robomakery/pvc-powerchair/README.md

# PVC Powerchair

Pediatric powerchair initially developed at BYU and the [Open Wheelchair Foundation](http://openwheelchair.org/).

This project tracks enhancements to the chair made by [Robomakery](http://robomakery.com).

## Project Summary

[Short Google Slides Presentation](https://docs.google.com/presentation/d/e/2PACX-1vQH72_SPbROlJtIxm5qiG1kyvUSaIGlaVXuoVhn0pRb-agA25kUbpgHu_BZxM33IaVWwLDGMfL6djqC/pub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)

## Getting Involved

We welcome new contributors!

First, there is a Google Group mailing list for development discussion:

https://groups.google.com/forum/?hl=en#!forum/robomakery-pvc-chair

Please join that group and introduce yourself.  We also have bi-weekly online planning meetings via Zoom.

If you are in the San Diego area, we also meet to discuss this project on the first Tuesday of every month as part of the [San Diego Robotics Club](https://www.meetup.com/roboticsclub/).

## Tools

* [FreeCAD](https://www.freecadweb.org/)
* [ROS](http://www.ros.org/)

## Versions

### Version Currently Under Development:

*0.1.0*

## License Information

[Software is licensed under GNU General Public License V3](SOFTWARE_LICENSE)

[Hardware is licensed under CERN Open Hardware Licence v1.2](HARDWARE_LICENSE)
