robomakery/pvc-powerchair/hardware/cad/README.md

We use [FreeCAD](https://www.freecadweb.org/) for CAD and store the files here.
