robomakery/pvc-powerchair/software/src/pvcchair_description/README.md

pvcchair_description
===

To generate the URDF description, run

```bash
rosrun xacro xacro $(rospack find pvcchair_description)/urdf/pvcchair.urdf.xacro
```
