robomakery/pvc-powerchair/archive/README.md

### Version 5

Theme: Rocker-Bogie Experiment

Updates:

* Rocker-Bogie Suspension
* Self-leveling seat

Prototype Completion Date: TBD

[read more](v5)

### Version 4

Theme: Metal Frame, oDrive, Initial ROS

Updates:

* oDrive Motor Controller
* oDrive Brushless Motors + encoders + gearbox
* oDroid ROS Control
* Metal Frame w/ MakerPipe
* Front-wheel drive

Prototype Completion Date: Build In Progress

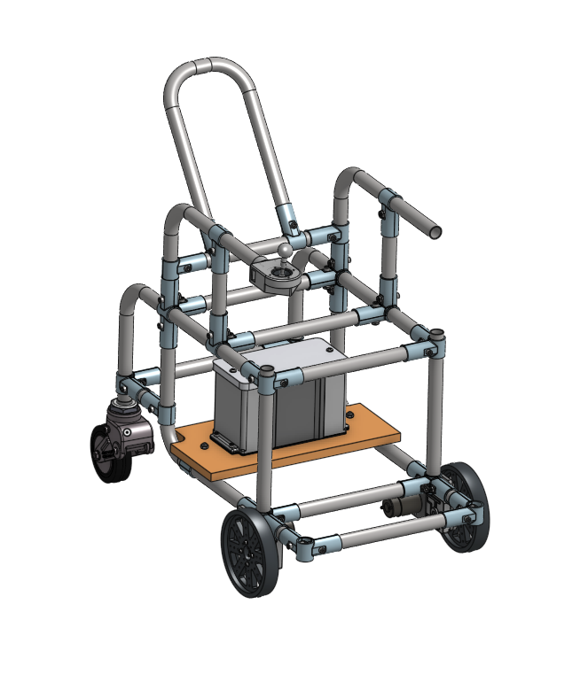
[picture p1: archive/v4/images/pvc-chair-v4-design.png]
PVC Powerchair v4 frame


[read more](v4)

### Version 3

Theme: UCSD ECE 191 Winter / Spring Projects

Updates:

* Brushless Hub Motors with Hall Sensors
* LiFePo4 Battery
* Rear-wheel drive

Prototype Completion Date: 2018-06-15

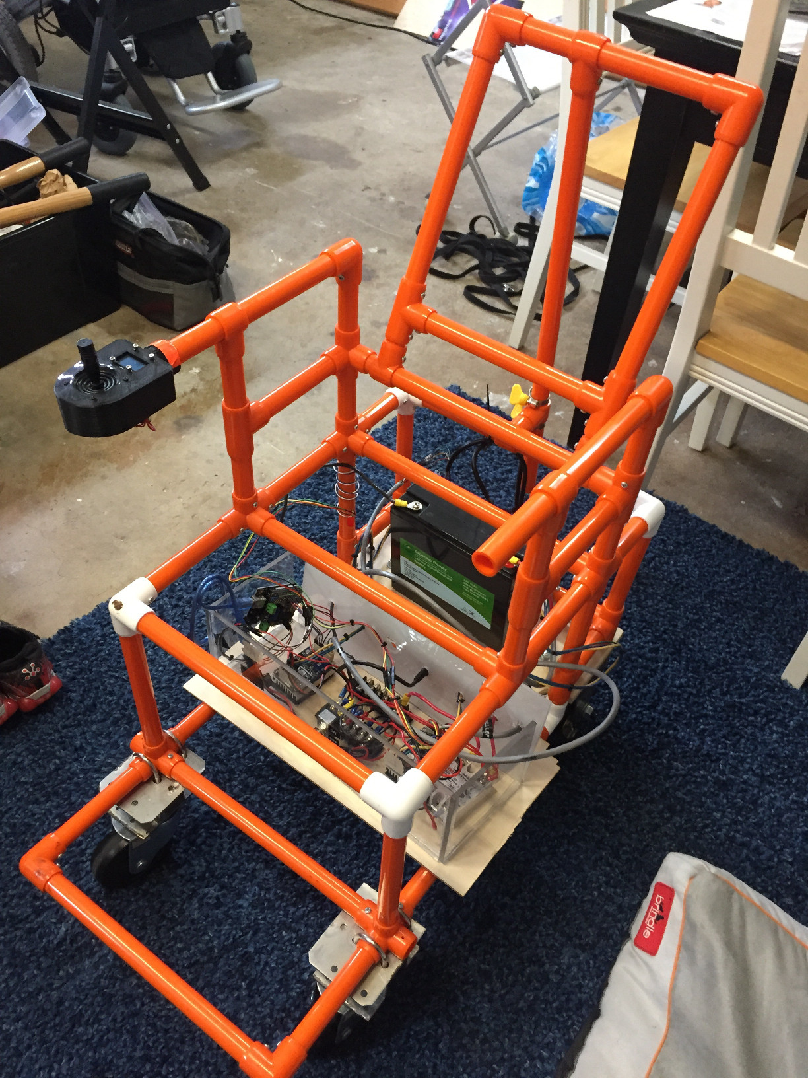
[picture p2: archive/v3/images/pvc-chair-v3-1.jpg]
PVC Powerchair v3 1


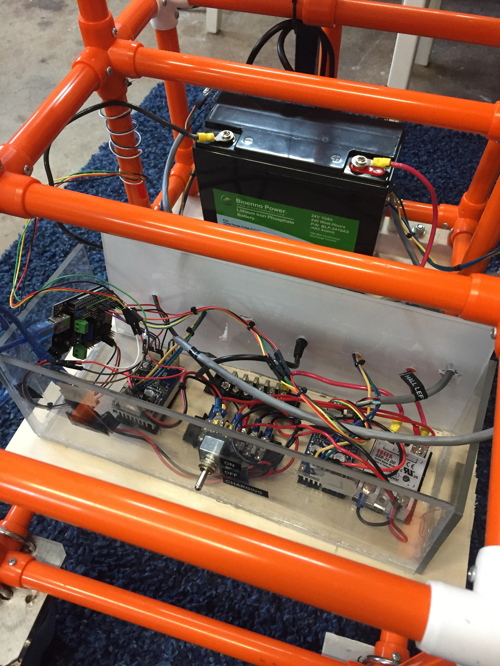
[picture p3: archive/v3/images/pvc-chair-v3-2.jpg]
PVC Powerchair v3 2


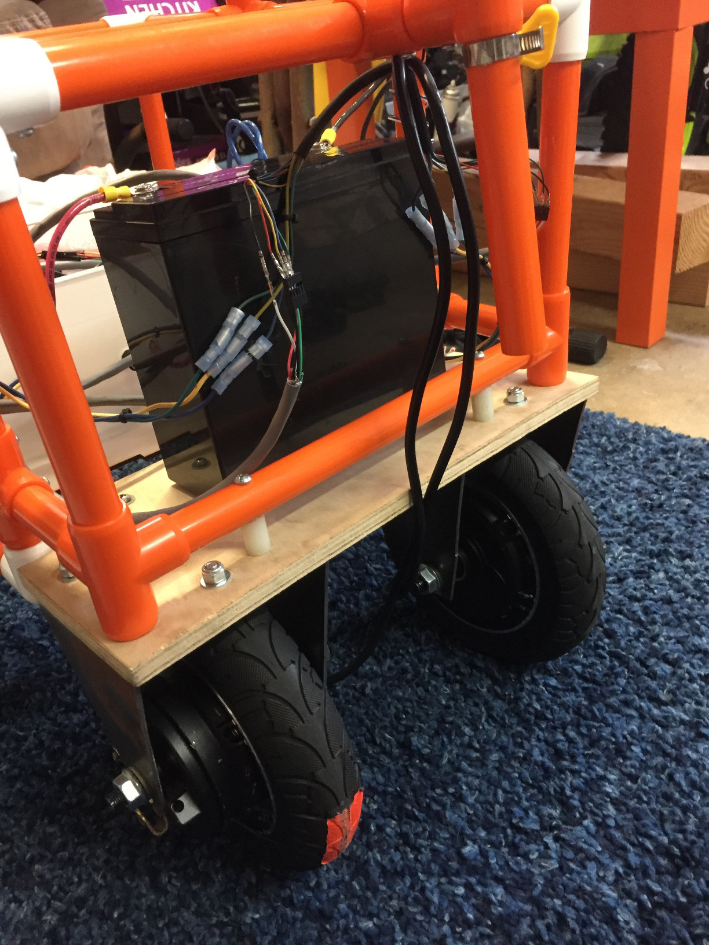
[picture p4: archive/v3/images/pvc-chair-v3-3.jpg]
PVC Powerchair v3 3


[read more](v3)

### Version 2

Theme: Move to COTS electronics

Updates:

* Arduino instead of custom boards
* Sabertooth Motor Controller
* OLED Battery Display
* Plug-in Battery Charging

Prototype Completion Date: 2017-11-04

PVC Powerchair v2 test drive (https://www.youtube.com/watch?v=sLA0mYiXbEk)

[read more](v2)

### Version 1

Theme: Original design build

Updates:

* Minor changes to original design

Prototype Completion Date: 2016-04-27

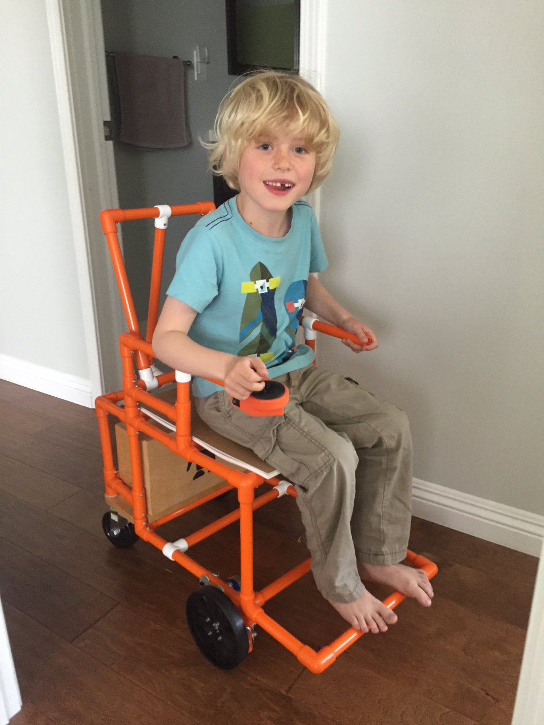
[picture p5: archive/v1/images/pvc-chair-v1.jpg]
PVC Powerchair v1 with tester


[read more](v1)
