robomakery/pvc-powerchair/archive/v4/README.md

## PVC Chair Version 4

Status: design in progress

Theme: Metal Frame, oDrive, Initial ROS integration

Updates:

* oDrive Motor Controller
* oDrive Brushless Motors + encoders + gearbox
* oDroid ROS Control
* Metal Frame w/ MakerPipe
* Front-wheel drive

### Docs

[BOM](design/PVC_CHAIR_V4_BOM_20181205_005.xls)

[OnShape CAD Model](https://cad.onshape.com/documents/9732789dff1ad6d245e6f6cd/w/41a982015f5ddfd27778e331/e/463536132cf1bdc68d806583)

### Contributors

* Dylan Vaughn
* Aki Kono
* Steven Berneberg
* Hamid Badiozamani
* Collins Mwangi

### Gallery

PVC Version 4

PVC Powerchair v4 frame
