robomakery/pvc-powerchair/archive/v3/README.md

## PVC Chair Version 3

Status: prototype completed on 2018-06-15

Theme: UCSD ECE 191 Winter / Spring Projects

Updates:

* Brushless Hub Motors with Hall Sensors
* LiFePo4 Battery
* Rear-wheel drive

### Contributors

Project Mentors

* Dylan Vaughn
* Jack Silberman

UCSD ECE 191 Project Members

_Winter 2018_

* Alex Tam
* David Lee
* Emily Reveles

_Spring 2018_

* Darlene Montesano
* David Lai
* Ibrahim Aldabbagh
* Jooyoung Park

### Gallery

PVC Version 3

PVC Powerchair v3 1

PVC Powerchair v3 2

PVC Powerchair v3 3
