robomakery/pvc-powerchair/archive/v2/README.md

## PVC Chair Version 2

Status: prototype completed on 2017-11-04

Theme: Move to COTS electronics

Updates:

* Arduino instead of custom boards
* Sabertooth Motor Controller
* OLED Battery Display
* Plug-in Battery Charging

### Docs

* [Component Diagram](docs/pvc-chair-component-diagram.png)
* [BOM](docs/PVC-Parts-List-V2.xls)

### Contributors

* Dylan Vaughn
* Steven Berneberg
* Aki Kono

### Gallery

PVC Powerchair v2 test drive

PVC Powerchair v2 test drive (https://www.youtube.com/watch?v=sLA0mYiXbEk)
