robomakery/pvc-powerchair/archive/v2/docs/electronics_diagram.pdf

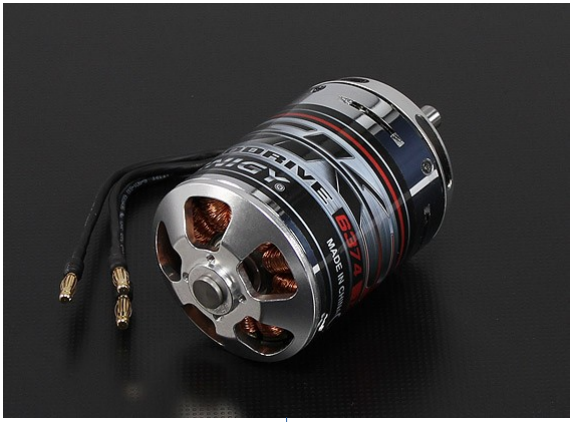
[picture p14: figure]

How are these
three wires connected?
- 3 phase motor drive signal

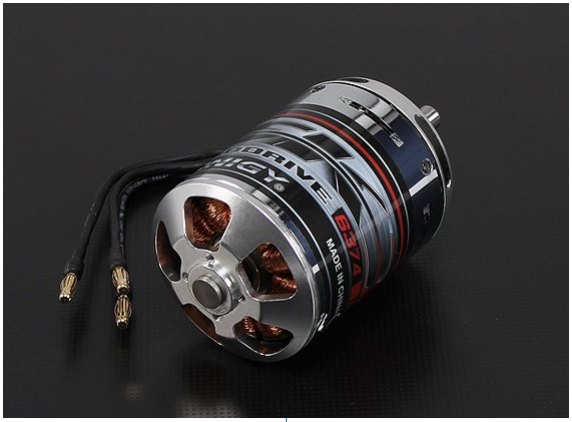
[picture p15: figure]

How are these
three wires connected?
- 3 phase motor drive signal

CAN add-on board
(On STM32f0-discovery)

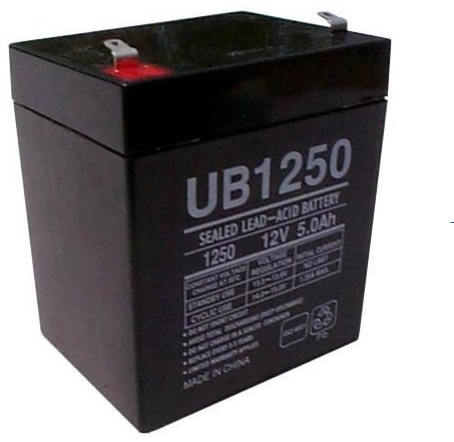
[picture p16: figure]
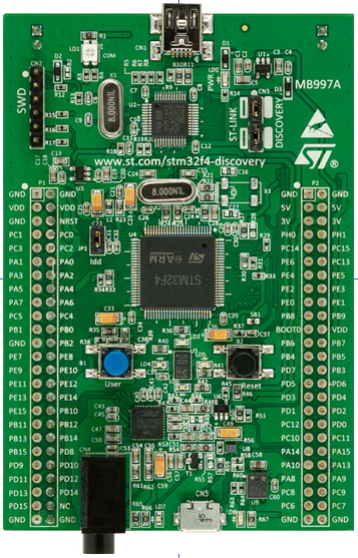
[picture p17: figure]
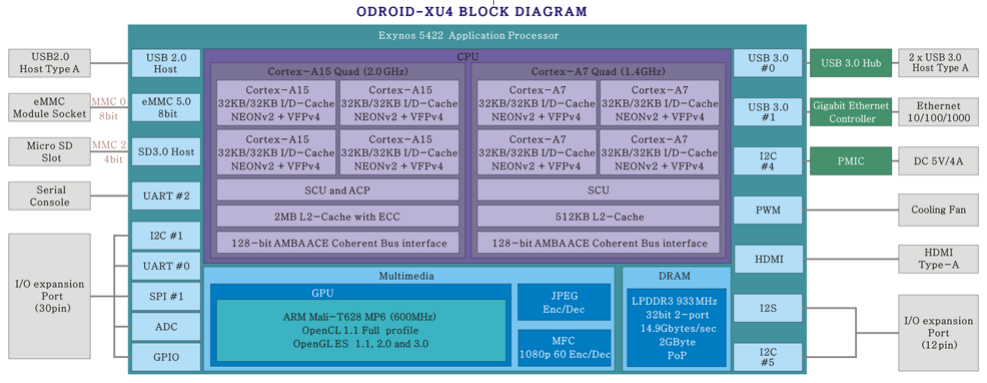
[picture p18: figure]
