robomakery/pvc-powerchair/BOM-20181206_002.xls

Sheet: MCs
Part Number | Description | Pipe Length (mm) | QTY | Total length
MC005 | See dwgs | 250 | 11 | 2750
MC006 |  | 117 | 4 | 468
MC007 |  | 62 | 6 | 372
MC009 |  | 200 | 1 | 200
MC0012 |  | 250 | 2 | 500
MC0013 |  | 250 | 1 | 250
MC010_S |  | 437 | 4 | 1748
MC011_S |  | 229 | 2 | 458
MC002_S |  | 317.5 | 2 | 635
MC0015_S |  | 151.5 | 2 | 303
TOTAL MC |  | mm | QTY | Overall length
 |  | 2264 | 35 | 7684
 |  | Convert to Inches |  | 302.5
 |  | Convert to feet |  | 25.2

Sheet: Cost Rollup
Part | Price | QTY | Part # | Retailer | Web Page | Date Ordered | Date Received | Sub-Total
Metal Conduit & Maker Pipe Connectors, end plugs + Hardware
3/4 inch MC pieces | $5.90 per foot | 25.2 feet= (2.52 times) |  | Home Depot |  |  |  | $14.87
4-Way MP Connector | $6.75 | 4 |  | Maker Pipe | https://www.makerpipe.com/shop |  |  | $27.00
90 degree MP Connector | $5.25 | 12 |  | Maker Pipe | https://www.makerpipe.com/shop |  |  | $63.00
T MP Connector | $2.75 | 16 |  | Maker Pipe | https://www.makerpipe.com/shop |  |  | $44.00
45 degree MP connector | $4.25 | 4 |  | Maker Pipe | https://www.makerpipe.com/shop |  |  | $17.00
End Plug/Rubber plugs | $0.50 | 13 |  | Maker Pipe | https://www.makerpipe.com/shop |  |  | $6.50
M6 Lock nuts | $0.15 | 62 |  | Grainger | https://www.grainger.com/category/hex-nuts/nuts/fasteners/ecatalog/N-8li |  |  | $9.30
M8 Lock nuts | $0.15 | 4 |  | Grainger | https://www.grainger.com/category/socket-head-cap-screws/socket-screws-and-set-screws/fasteners/ecatalog/N-15gx |  |  | $0.60
M6x1x35 Socket Head Cap Screw | $0.16 | 52 |  | Grainger | https://www.grainger.com/category/socket-head-cap-screws/socket-screws-and-set-screws/fasteners/ecatalog/N-15gx |  |  | $8.55
M6x1x16 Socket Head Cap Screw | $0.12 | 4 |  | Grainger | https://www.grainger.com/category/socket-head-cap-screws/socket-screws-and-set-screws/fasteners/ecatalog/N-15gx |  |  | $0.47
M6x1.25x12 Socket Head Cap Screw | $0.13 | 4 |  | Grainger | https://www.grainger.com/category/socket-head-cap-screws/socket-screws-and-set-screws/fasteners/ecatalog/N-15gx |  |  | $0.53
M6x1x45 Socket Head Cap Screw | $0.23 | 5 |  | Grainger | https://www.grainger.com/category/socket-head-cap-screws/socket-screws-and-set-screws/fasteners/ecatalog/N-15gx |  |  | $1.17
M6x1x40 Socket Head Cap Screw | $0.16 | 2 |  | Grainger | https://www.grainger.com/category/socket-head-cap-screws/socket-screws-and-set-screws/fasteners/ecatalog/N-15gx |  |  | $0.32
Shipping |  |  |  |  |  |  |  | $10.00
MP, MC, end plugs + hardware Total |  |  |  |  |  |  |  | $203.32
Frame
Seatbelt | $12.50 | 1 | 45928 | 1-800-WHEELCHAIR.COM | www.wheelchair.com |  |  | $12.50
Shipping |  |  |  |  |  |  |  | $4.00
Casters | $7.50 | 2 | PRES5024ZN-TPR | A1-Casters | www.a1casters.com |  |  | $15.00
Shipping
SeatCushion
Shipping
Shorter Bottom Acrylic Plate |  | 1
Bottom Acrylic Plate |  | 1
Upper Acrylic Plate |  | 1
Shipping
Frame Total |  |  |  |  |  |  |  | $31.50
DRIVETRAIN
BLDC Motor/Dual Shaft Motor | $70.00 | 2 | D5065 - 270KV | odrive | https://odriverobotics.com/shop/odrive-custom-motor-d5065 |  |  | $140.00
Quandrature encoder | $39.00 | 2 | CUI AMT102 | odrive | https://odriverobotics.com/shop/cui-amt-102 |  |  | $78.00
o Drive v 3.4 Motor controller | $119.00 | 1 | Drive v 3.4 | odrive | https://odriverobotics.com/shop/odrive-v35 |  |  | $119.00
Motor enclosure | $30.00 | 2 |  |  |  |  |  | $60.00
Caster socket | $5.00 | 2 |  |  | https://www.amazon.com/Oajen-caster-socket-diameter-4-pack/dp/B00B9KRA08?s=industrial |  |  | $10.00
Key Stock | $5.75 | 2 | WWG70025002501 | Stafford Manufacturing Corp. | https://www.grainger.com/product/GRAINGER-APPROVED-12-18-8-Stainless-Steel-Undersized-5UE61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 |  |  | $11.50
PX36 Gear box & accessories | $52.00 | 2 | 57PX-36 |  | https://www.aliexpress.com/item/High-Torque-Ratio-36-1-Reducer-China-Gear-Reducer-NEMA23-Stepper-Motor-Speed-Reducer-Planetary-Gearbox/32764813940.html |  |  | $104.00
Pnuematic Wheel | $38.00 | 2 | AM-0970 | AndyMark | https://www.andymark.com/products/8-in-pneumatic-wheel |  |  | $76.00
Motor&Gear Al Bracket | $25.00 | 2 |  |  | Customized piece |  |  | $50.00
Shaft Collar | $25.00 | 2 | 1A010AFCK | Stafford Manufacturing Corp. | https://datasheets.globalspec.com/ds/113/stafford/C499E490-FDFF-49F5-A299-68A67E42BAE7 |  |  | $50.00
M3-0.5x8 Socket Head Cap Screw | $0.15 | 4 |  |  | https://www.grainger.com/category/socket-head-cap-screws/socket-screws-and-set-screws/fasteners/ecatalog/N-15gx |  |  | $0.60
M3 washer | $0.15 | 4 |  |  | https://www.grainger.com/category/socket-head-cap-screws/socket-screws-and-set-screws/fasteners/ecatalog/N-15gx |  |  | $0.60
#40 Tap Drill |  | 1 |  |  |  |  |  | $0.00
M3-0.5 tap |  | 1 |  |  |  |  |  | $0.00
M5-0.8x8 Socket Head Cap Screw | $0.15 | 4 |  |  | https://www.grainger.com/category/socket-head-cap-screws/socket-screws-and-set-screws/fasteners/ecatalog/N-15gx |  |  | $0.60
M3 washer | $0.15 | 4 |  |  | https://www.grainger.com/category/socket-head-cap-screws/socket-screws-and-set-screws/fasteners/ecatalog/N-15gx |  |  | $0.60
 |  |  |  |  |  |  |  | $0.00
 |  |  |  |  |  |  |  | $0.00
 |  |  |  |  |  |  |  | $0.00
Shipping |  |  |  |  |  |  |  | $20.00
Drive Train Total |  |  |  |  |  |  |  | $720.90
ELECTRONICS
2 Axis Joystick | $19.99 | 1 | RB-Sct-283 | Robotshop | www.robotshop.com |  |  | $19.99
Arduino UNO |  |  |  |  |  |  |  | $0.00
H-Bridge |  |  |  |  |  |  |  | $0.00
Power converter |  |  |  |  |  |  |  | $0.00
Battery | $189.99 | 1 | BLF-2410AS |  | https://www.bioennopower.com/collections/24v-series-lifepo4-lithium-iron-phosphate-batteries/products/24v-10ah-lfp-battery-abs-blf-2410as |  |  | $189.99
Battery Charger | $39.01 | 1 | BPC-2402C |  | https://www.bioennopower.com/collections/24v-series-lifepo4-lithium-iron-phosphate-batteries/products/24v-10ah-lfp-battery-abs-blf-2410as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 |  |  | $39.01
Connectors | $20.00 | 2 |  |  |  |  |  | $40.00
Electronics box | $70.00 | 1 | YH-100806-03 | PolyCase | https://www.polycase.com/yh-100806 |  |  | $70.00
 |  |  |  |  |  |  |  | $0.00
 |  |  |  |  |  |  |  | $0.00
 |  |  |  |  |  |  |  | $0.00
Electronics Total |  |  |  |  |  |  |  | $358.99
Grand Total |  |  |  |  |  |  |  | $1314.71
