robomakery/pvc-powerchair/archive/v3/BOM.md

Motor Controllers:

* [Motor Controller - SODIAL(R)DC 12V-36V 500W Brushless Motor Controller Hall Motor Balanced Car Driver Board](https://www.amazon.com/gp/product/B01LQ4FF4O/ref=oh_aui_search_detailpage?ie=UTF8&psc=1)
