robomakery/pvc-powerchair/archive/v4/BOM.md

BOM
===

Frame
-----

*Electrical Metal Tubing*

* 3 * [10ft 3/4 inch EMT Tubing](https://www.homedepot.com/p/3-4-in-EMT-Conduit-101550/100400406) - $5.90/each

*Maker Pipe*

* 10 * [T connector](https://www.makerpipe.com/shop/maker-pipe-conduit-t-connector) - $2.75/each
* 2 * [4 Way connector](https://www.makerpipe.com/shop/four-way-connector-4mgmh) - $6.75/each
* 8 * [90 degree connector](https://www.makerpipe.com/shop/90-degree-connector-pre-sale) - $5.25/each

*Parts Subtotal*

```
(+
 (* 3 5.90)
 (* 10 2.75)
 (* 2 6.75)
 (* 8 5.25))
```

$100.70

*Tools Required*

* 1 * [pipe bender](https://www.homedepot.com/p/Ideal-3-4-in-EMT-Aluminum-Bender-Head-with-Handle-74-047/100341460) - $38.80/each

*Tools Subtotal*

```
(+
 (* 1 38.80))
```

$38.80

Battery
-------

* 1 * [LiFePo 24V 10Ah battery + charger](https://www.bioennopower.com/collections/24v-series-lifepo4-lithium-iron-phosphate-batteries/products/24v-10ah-lfp-battery-abs-blf-2410as) - $229.99/each

Drive Train
-----------

* 2 * [BLDC motor](https://odriverobotics.com/shop/odrive-custom-motor-d5065) - $69.00/each
* 2 * [Quadrature encoder](https://odriverobotics.com/shop/cui-amt-102) - $39.00/each
* 1 * [oDrive v3.4 Motor Controller](https://odriverobotics.com/shop/odrive-v35) - $119.00/each
* 2 * [Motor Enclosure](https://cad.onshape.com/documents/6668fd76e2dbada55127ed36/w/1e8250b1f83ac970e8ac258d/e/d9d08ef906d47e24e628fb72) - $30.00/each (ESTIMATE)
* 2 * [Planetary Gearbox](https://www.aliexpress.com/item/High-Torque-Ratio-36-1-Planetary-Gear-Reducer-For-NEMA23-Stepper-Motor-High-Precision-Low-Noise/32764813940.html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) - $51.30/each
* 2 * [Pneumatic wheels](http://www.andymark.com/8-inch-pneumatic-wheel-p/am-0970.htm) - $37.00/each
* 2 * [Caster wheels](http://www.footmaster.net/products/detail.asp?bic_code=Shock&small_code=GDS&p_name=GDS-100-ASS-LUD) - $30.00/each (estimate)
* 2 * [Caster Center Bolt] M12 X 1.75P (this should come as part of the caster assembly above)
* 2 * [Caster socket](https://www.amazon.com/Oajen-caster-socket-diameter-4-pack/dp/B00B9KRA08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) - $16/each  
* 2 * [Shaft Mounting Collars](http://shaft-collars-couplings.staffordmfg.com/item/all-categories/accu-flange--shaft-collars/1a010afck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) - $25.00/each (estimate)
* 2 * [Aluminum Bracket for Motor&Gear] measuring 145mm by 70 mm to be bent accordingly - $20 (estimate)
* 1 * [Acrylic Bottom plate] measuring 353mm by 345mm by 2mm - $?? 
* 1 * [Acrylic Bottom plate] measuring 335mm by 300mm by 2mm - $?? 
* 1 * [Anti-Vibration Foam](https://www.amazon.com/dp/B016C5FJE8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) - $10 
* 1 * [Electronics Box] 3D printed - $??
* 5 * [Rubber plugs] with 20.8mm diameter, for plugging into Conduit ends Check Home depot - $10 (estimate)
* 4 * [Rubber plugs 2] with 23.6mm diameter, for plugging into MC connectors Check Home depot - $10 (estimate)
* 8 * [M4 X 20] Hex Socket Head Cap Bolt - $1/each (estimate) 
* 8 * [M4 X 35] Hex Socket Head Cap Bolt - $1/each (estimate)
* 6 * [M5 X 55] Hex Socket Head Cap Bolt - $1/each (estimate) 
* 4 * [M6 X 12] Hex Socket Head Cap Bolt - $1/each (estimate) 
* 4 * [M6 X 20] Hex Socket Head Cap Bolt - $1/each (estimate)
* 40 * [M6 X 35] Hex Socket Head Cap Bolt - $1/each (estimate) 
* 2 * [M6 X 45] Hex Socket Head Cap Bolt - $1/each (estimate)
* 16 * [M4] Hex locknuts - $1/each (estimate)
* 6 * [M5] Hex locknuts - $1/each (estimate)
* 52 * [M6] Hex locknuts - $1/each (estimate)

```
(+
 (* 2 69)
 (* 2 39)
 (* 1 119)
 (* 2 30)
 (* 2 51.30)
 (* 2 37)
 (* 2 30)
 (* 2 16)
 (* 2 25)
 (* 2 20)
 (* 1 10)
 (* 1 10)
 (* 1 10)
 (* 74 1)
 (* 74 1))
```

$931.6

*Motor Cover to Motor Enclosure*

* 4 * M3-0.5x8 socket cap screw
* 4 * M3 washer

_Drill and tap into motor enclosure_

* #40 tap drill
* M3-0.5 tap

*Motor Cover to Planetary Gearbox body*

* 4 * M5-0.8x8 socket cap screw
* 4 * M3 washer

*Motor to Motor cover*

* 4 * M4-0.7x8 socket cap screw
* 4 * M4 washer

Seat
----

* 2 * yard outdoor fabric (fabric for this prototype purchased at [Threads](https://www.yelp.com/biz/threads-san-diego) for $17 / yard)
* 1 * sheet of thin plywood
* 20 * staples

*Tools*

* Staple gun
