robomakery/pvc-powerchair/archive/v2/hardware/printed_parts/JoystickEnclosure.STL

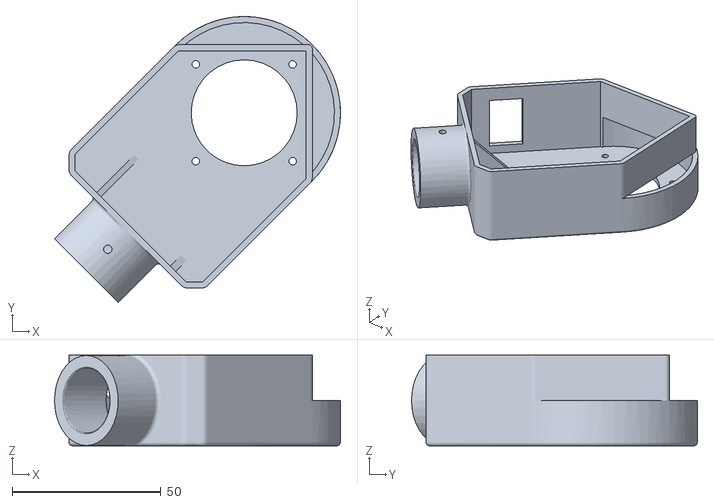
[picture p19: CAD file, 2017-03-30, an earlier design]
archive/v2/hardware/printed_parts/JoystickEnclosure.STL
96.0 x 96.0 x 30.5
