robomakery/pvc-powerchair/(list of files, cad)

Other CAD files:
hardware/cad/pvc-chair.FCStd
