robomakery/pvc-powerchair/CHANGELOG.md

Unreleased
----------

* Initial prototypes
* Moving documentation to wiki
