robomakery/pvc-powerchair/software/src/pvcchair_description/CHANGELOG.rst

^^^^^^^^^^^^^^^^^^^^^^^^^^^^^^^^^^
Changelog for pvcchair_description
^^^^^^^^^^^^^^^^^^^^^^^^^^^^^^^^^^

Forthcoming
-----------
* Redefined piping and connectors to allow use within a single link.
* Restructured main parts so that each defines a single link.
* Restructured xacro includes to be compatible with in order processing.
* Added urdf models for the gearbox plates, wheels and casters.
* Gathered urdf parameters in parameters.urdf.xacro.
* Added dae design files for the basic components.
* Added urdf models for the basic components.
* Added urdf model for the frame of the wheelchair.
