robomakery/pvc-powerchair/(threads)

Thread 1 (2016-05-06):

change to Arduino processor

dylanvaughn, 2016-05-06:
from @SBerneberg

The processor that will control the wheelchair has the following requirements:

2 – PWM – Speed control for right and left drive motor
2 – DIR – Direction control for right and left drive motor
2 – Analog In – The two potentiometers in the joystick
1 – UART – Rx/Tx for Bluetooth module
1 – I/O – LED Headlight control
2 – Analog In – Optional Battery Voltage and Battery current.

Looking at the Arduino offerings, only the Mega provides more that one UART.  Others have a UART but they are used for the USB interface and thus may not be used.

miliapa, 2016-06-15:
This might help with board selection:
http://makezine.com/comparison/boards/

There are several with built in bluetooth support.

Alternatively, look for a board with a bluetooth shield available.

If your goal is to use ROS, you might want to consider a board capable of running Linux.

bus710, 2016-06-25:
Since Arduino's basic approach doesn't accept timer interrupt, I rather pick other systems. I still need to consider affordable price tags though.

Thus, I am thinking to use STM32F0-disconvery or Mbed since both have pros such as decent price, enough performance, easy to use, and open echo system. Especially, the discovery board will be upgraded to OpenCR, which is a part of real time ROS system soon. (so the middleware in the board will natively exchange ROS message with a x86/Ubuntu based system.)

I want to listen from you about this idea.

dylanvaughn, 2016-06-28:
@bus710 can you give me more details on the Arduino interrupt issue?

Regarding high-level board design, I think we should have a micro linux computer (I have a [snickerdoodle](https://www.crowdsupply.com/krtkl/snickerdoodle) coming soon which we could use for this - or even something like the [Intel NUC](http://www.intel.com/content/www/us/en/nuc/overview.html)) which runs ROS and sends control instruction to arduino boards which interface with the motor drivers, etc. via the [ros_arduino_bridge](http://wiki.ros.org/ros_arduino_bridge).

Maybe we should make a diagram outlining the board setup - something like this:

https://lh3.googleusercontent.com/-_g2DF_fLgn4/V26gBZy1c4I/AAAAAAAAADA/8IWbXK99Ebge-WIxoAY7ONzaaNgUJDezACLcB/s1600/schema_JQR_5.jpg

bus710, 2016-06-28:
1.
as you know, polling may cause timing issues to run motors.

if we use too many motors over than arduino's maximum PWM output, we have
to drive one or more motors by using timer or polling. in this case,
polling can make some delay. (if we use arduino mega, that's nice to have.)
however, i agree that arduino can be the best approach for the first step.

2.
i wish we can use NUC to avoid compatibility issue in drivers (sensor,
network, and so on.) but we also need to think about power source.

3.
yes, let's talk about a rough diagram.

SJ
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

Closed 2017-05-03.

Thread 10 (2016-05-06):

Source remaining parts

dylanvaughn, 2016-05-06:

SBerneberg, 2016-05-17:
I have used these auto reset breakers with great success.  I usually mount them on the battery; a convenient location.  Here is a picture:
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

SBerneberg, 2016-05-17:
I usually get these in El Cajon for about $2.25 for a 30amp breaker.

dylanvaughn, 2017-05-03:
Find sources for these parts, purchase, and integrate into drawing and prototype v2:

* electro-mechanical circuit breaker instead of automotive fuse
* on / off switch
* charger port
* trickle charger adapter

dylanvaughn, 2017-07-07:
Still left to buy:

* Custom Arduino shield
* Voltage divider
* Fan
* JST connectors
* Power plug
* Power jack
* Hose Clamp

dylanvaughn, 2017-07-09:
@rbeetem for the custom arduino shield should I get this one:

http://www.jameco.com/z/A000082-Arduino-Arduino-Uno-Proto-Shield-PCB-only-_2152438.html

which is just the bare PCB only, or this one:

http://www.jameco.com/z/A000077-Arduino-Arduino-UNO-Proto-Shield-Rev-3-assembled_2152391.html

which has a couple of things already set up?

dylanvaughn, 2017-07-09:
@rbeetem is this what I want?  It is prime :)

https://www.amazon.com/Arduino-Proto-Shield-R3-Assembled/dp/B007QXTRNA

rbeetem, 2017-07-18:
The bare PCB is the one I would recommend.
http://www.jameco.com/z/A000082-Arduino-Arduino-Uno-Proto-Shield-PCB-only-_2152438.html

The only one is designed to have additional shields placed on top, which we currently have no desire to do.

dylanvaughn, 2017-07-22:
@rbeetem I'm planning on ordering this today - does it look right?

https://www.amazon.com/gp/product/B01J1KM3RM/ref=ox_sc_act_title_2?smid=A2OVMUS055KMW5&psc=1

rbeetem, 2017-07-23:
@dylanvaughn Looks reasonable to me.

Closed 2017-08-02.

Thread 11 (2016-05-06):

Buy/Build LiFePO4 battery pack

dylanvaughn, 2016-05-06:
LiFePO4

https://en.wikipedia.org/wiki/Lithium_iron_phosphate_battery

http://www.wheelchairdriver.com/BM-MK3-lithium-charging-powerchair.htm

http://www.wheelchairdriver.com/BMS.htm

dylanvaughn, 2017-11-15:
@SBerneberg you interested in batteries? :) I would like to build what is referenced in the links above.

SBerneberg, 2017-11-15:
I am currently making a spreadsheet of the available hubs from CONHISMOTOR.  We can look at the specs and decide which one we want to use.  Then we know the battery requirements; Voltage, Current, AHrs, etc.

dylanvaughn, 2018-02-22:
Here is the battery selected by the Capstone team:

https://www.bioennopower.com/collections/24v-series-lifepo4-lithium-iron-phosphate-batteries/products/24v-10ah-lfp-battery-abs-blf-2410ts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

Closed 2018-06-25.

Thread 2 (2016-05-06):

Bigger motors

dylanvaughn, 2016-05-06:

dylanvaughn, 2016-05-09:
from @SBerneberg

Potential new motors:

http://www.allelectronics.com/make-a-store/item/dcm-563/12vdc-right-angle-gear-head-motor-with-worm-drive/1.html

very powerful, right angle (left angle is available), 12VDC, 1.3A MAX.  The robots that the students use these motors in typically draw about 500mA.  Approximately double what the current motor draws, but with a 9AHr battery, that is about 9 hours of CONTINUOUS operation.

SBerneberg, 2016-05-17:
This motor has a worm drive for moving a car seat.  We had to remove and modify the worm drive.  Was not that difficult but you will need a lathe to modify the worm drive.  Again, not that difficult but not everyone has a lathe.

dylanvaughn, 2016-05-18:
@SBerneberg I would prefer not to have to modify the motors - are there some brushless motors we could look at?

AdamTeays, 2017-05-17:
So looking at what we need motor-wise, I ran some calculations based on two criteria: that the chair must be able to go up a 7-degree ramp with a 50 lb. passenger, and that the chair can travel at around 5 mph (typical speed of an electric powered wheelchair).

So, first off, I went ahead and calculated what the stall torque would be, which came out to be 9.14 lb-in (10.53 kg-m, or 146.24 oz-in).

Onto determining the motor speed: since the wheel diameter (6 inches), the motors would need to run at ~280 rpm to reach 5 mph. If we want the chair to move 3 mph up an incline, that would be ~168 rpm.

I assume that some of us are familiar with how DC motor specs are calculated. If not, here is a helpful link about that (where specs are typically the stall torque, no load speed, and maximum efficiency).
[http://www.micromo.com/technical-library/dc-motor-tutorials/motor-calculations](url)

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

All we need, is a motor that has the point (9.14 lb-in, 168 rpm) at or below that blue line.

Calculation proofs: [https://docs.google.com/document/d/1mss5ZFxsw8eWR4RWg8JPl5gAOq1itzg9Wl9rDcymRVQ/pub](url) (ignore the little question marks, those were supposed to be the symbol for degrees)

Now to actually find a 12-volt DC motor that fits this criteria.

AkiKono, 2017-05-18:
Hello,

Thank you so much for sharing :) This is a good input :)

I was planning to report what I have done so far to the team at the next
meeting, but since there is an attention to motor torque and specs, I guess
I should also share the updates with the team.

I have been using a google sheet I created to calculate torque on the motor
in various situations. Here is the link.
https://docs.google.com/spreadsheets/d/12mFd3bs58vSQ7STA4lI8He2xesg1GwQOK_4B4z5c2mo/edit?usp=sharing

And attached is a video showing how much current the motor is using while
it is under the load.
I am thinking to test the motor with a known external load. (not just
applying random unknown loads using fingers like in the video. haha)

I have been working alone on this motor and motor control since SJ left,
but I am always open to working with people who are interested in :)

Anyway, more detailed report will be ready in the next meeting.

Thanks :)
Aki

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

dylanvaughn, 2017-11-08:
need to get this motor working again

dylanvaughn, 2018-01-06:
Hub motor option:

http://www.uumotor.com/store/31-8-inch-small-motor-no-hall-sensors-for-electric-scooter.html

dylanvaughn, 2018-02-22:
this is the motor selected by the Capstone team:

https://www.aliexpress.com/item/24V-36V-48V-8Inch-Electric-Wheel-Hub-Motor-350W-Brushless-Non-Gear-Hub-Motor-For-Electric/32837818637.html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

Closed 2018-06-25.

Thread 3 (2016-05-06):

Improved motor driver

dylanvaughn, 2016-05-06:
The motors that we will be using consume a little more power.  Use higher power, lower resistance FET drivers.  Design that will prevent the opportunity to turn on both series FET's at the same time.

bus710, 2016-09-19:
< Update >

So far I installed ARM-GCC on Ubuntu 16.04. it could be easier but there was too many confusing ways to do it so that it took pretty long time than my initial expectation. Essentially, we can just leverage a PPA from ARM (https://launchpad.net/~team-gcc-arm-embedded/+archive/ubuntu/ppa)

Now I am trying to do same way with Vedder's operation to run the motor I bought. (http://vedder.se/2015/01/vesc-open-source-esc/) After this, I will try to write my own code for STM32F0DISCOVERY, which will be a master controller for OpenESCs via CAN communication.

When I reach to this point, I will re-design the boards (Discovery and OpenESC) to make it to fit our purpose. Of course, I may adjust the motor and controller's parameter to drive our system. To do so, we need to test with a frame.

I very appreciate your patience.

Closed 2018-02-22.

Thread 4 (2016-05-06):

Add Bluetooth

dylanvaughn, 2016-05-06:
The question is regular BT or BLE.  Some devices cannot use BLE but all the newer devices can use it if you install the proper driver.

LeviLister, 2016-06-17:
Ordered this bluetooth arduino shield for testing with my Uno:
https://www.adafruit.com/products/1628

Figure we can consider other bluetooth shield/board options once we decide on the exact Arduino board

Closed 2018-02-22.

Thread 5 (2016-05-06):

Web-based control application

dylanvaughn, 2016-05-06:
Emergency stop, headlights of/off, Battery Voltage and estimated time remaining on the existing charge are some of the suggestions.

Thread 8 (2016-05-06):

Pneumatic tires

dylanvaughn, 2016-05-06:
research security aspects and propose new tires.

SBerneberg, 2016-05-17:
We have talked about pneumatic tires for the chair.  This one from Northern Tool is almost double the size and thus will cause the center of gravity to rise 6".  Need to think about this.
[12_5 x 2_25 5-Spoked.pdf](https://github.com/robomakery/pvc-powerchair/files/268829/12_5.x.2_25.5-Spoked.pdf)

Closed 2018-02-22.

Thread 13 (2016-05-20):

Create URDF model of chair

dylanvaughn, 2016-05-20:

dylanvaughn, 2016-11-02:
fixed in https://github.com/robomakery/pvc-powerchair/pull/25

Closed 2016-11-02.

Thread 15 (2016-05-22):

Navigation to known points

dylanvaughn, 2016-05-22:
Enable the ability, via the web interface control application, to name certain locations (i.e. Bathroom, Next to my bed, front door, fridge, etc).  These locations would be set manually by the operator.  That is, the operator of the chair would navigate manually to a location and then click a button the interface which would allow her to "name" the place the chair current is in.

Then, the operator could access a list of named locations and tell the chair to navigate to one of them.  So a use case is the operator is in the living room and would like to go to bed.  Instead of manually navigating to the bedroom, they can instead click on "bed" and the chair will navigate to that point.  The user should still be able to give controls via the joystick or web interface to guide the automated navigation.  This is similar to what is described here:

http://wiki.ros.osuosl.org/turtlebot_navigation/Tutorials/Autonomously%20navigate%20in%20a%20known%20map

dylanvaughn, 2019-06-05:
closing for now

Closed 2019-06-05.

Thread 16 (2016-05-27):

Improve battery / charging

dylanvaughn, 2016-05-27:
Current battery is difficult to access / charge.  Come up with alternate battery that is easier to charge (but does not use inductive charging).

dylanvaughn, 2016-06-15:
Look into using electric vehicle battery chargers / components

johanisforever, 2016-08-24:
I have attach a propose "inexpensive and easy battery charging design". The LEDs at the end are optional, however the "ON" LED will draw power from the battery, the power draw is negligent but during long period of inactivity (weeks) with the switch on the "ON" position the power draw would have to be taken into consideration.

[changing Ckt_1.pdf](https://github.com/robomakery/pvc-powerchair/files/433810/changing.Ckt_1.pdf)

I did not mention the require conductor size, but the minimum conductor size require for power carrying connection needs to be 14 gauge.  Assuming a 200Watt motor     (200Watt / 12 Volt = 16.66Amp)  See bellow
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

Closed 2017-11-15.

Thread 20 (2016-06-15):

Gazebo simulation

dylanvaughn, 2016-06-15:
basic gazebo simulation

dylanvaughn, 2016-06-15:
@bus710 to provide more details

bus710, 2016-06-16:
I am thinking to use Onshape to draw a new design for simulation so that I was looking for export option for DAE file. Althohg Onshape doesn't support DAE, STL is in the list. Also fortunately, There are bunch of apps and services, which provide converting between STL and DAE.

I guess I might try drawing some design by using Onshape and make some shapes in Gazebo this weekend.

dylanvaughn, 2016-06-17:
@bus710 it probably makes sense to just go ahead and make a URDF model for the chair to use in Gazebo - we are already tracking that task in #13.  I put that into this milestone.

bus710, 2016-06-17:
@dylanvaughn, that's true... I am editing one of my previous model to adjust for Gazebo 7. (Because the sdf was design for Gazebo 1.7 and makes some crash for Gazebo 7.)

bus710, 2016-06-18:
Although I just put three objects (body and two big wheel) yet, I think that I can build the first model in this weekend.

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

LeviLister, 2016-06-18:
Looks like a good start!

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

bus710, 2016-06-20:
I issued a PR for simulation to this repo.
Please let me know if I can merge my branch.

dylanvaughn, 2016-06-20:
@bus710 I left some comments on the PR

bus710, 2016-06-21:
@dylanvaughn, Yes, I saw your mention and it was very sincere. I will fix the PR soon.. Thank you!

Thread 24 (2016-09-28):

high-level systems diagram

dylanvaughn, 2016-09-28:
Create system diagram of components / electronics and their relationships

dylanvaughn, 2017-03-08:
[V1_5 Drawing (1).pdf](https://github.com/robomakery/pvc-powerchair/files/826528/V1_5.Drawing.1.pdf)

Here is the existing drawing that @SBerneberg did

dylanvaughn, 2017-04-05:
need to merge all drawings into a draw.io document.
include wires, screws

dylanvaughn, 2017-05-07:
WIP diagram can be found here:

https://github.com/robomakery/pvc-powerchair/blob/develop/docs/pvc-chair-component-diagram.png

dylanvaughn, 2017-06-07:
Need to:

* Integrate terminal block
* On/Off switch
* Arduino Protoshield
* add wire sizing to diagram

dylanvaughn, 2017-06-07:
Also:

* Charging Connector
* Charger
* Switch

dylanvaughn, 2017-06-11:
Lots of progress made:

https://github.com/robomakery/pvc-powerchair/blob/develop/docs/pvc-chair-component-diagram.png

Still have some TODOs but I think it is good enough to start building against.

rbeetem, 2017-06-20:
Updated with Arduino interfaces and pin list.

pvc-powerchair/docs/pvc-chair-component-diagram2.png

Analog pins are in short supply if we use I2C for the OLED, could use SPI on the digital pins instead.

dylanvaughn, 2017-06-20:
Looks good!  Can you also update the xml diagram source in github?

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

rbeetem, 2017-06-25:
Updated png and xml in github.

dylanvaughn, 2017-07-07:
last item to do on this is to rearrange diagram and add final wires to/from terminal block

Closed 2017-09-06.

Thread 28 (2017-03-07):

OnShape CAD drawing

dylanvaughn, 2017-03-07:
We already have this started here:

https://cad.onshape.com/documents/afa971ef5507b38d69394b06/w/1b6f32bd7bb64483d9a5f636/e/fce34e86e9aed7bf1dab338d

Needs to be finished

dylanvaughn, 2017-03-08:
Assign to Andrew - need to get github profile

dylanvaughn, 2017-03-31:
New OnShape document created:

https://cad.onshape.com/documents/d91a95f30dd3844dcfc2804c/w/6f43255d0f5dad638639cf32/e/45c92d8b4a03edc246f1764e

Discussion here:

https://groups.google.com/forum/#!topic/robomakery-pvc-chair/MgDmPHU2Rxw

dylanvaughn, 2017-05-03:
Update from planning meeting:

Finish motors and gearbox
Finish joystick
Diagram components (battery, electronics (Arduino Uno & Motor Driver))
Work on electronics box (see #38)

dylanvaughn, 2017-06-07:
done!

Closed 2017-06-07.

Thread 29 (2017-03-07):

Order PVC + other parts for prototype v2

dylanvaughn, 2017-03-07:
* PVC
* Two motors (get the ones that are existing)
* Nuts and bolts
* Gearboxes
* Joystick - need to source new joystick as old one came with old custom board
* Printed parts
* Arduino Uno
* H-bridge (James Newton)
* Breakout board for arduino (James Newton)

SBerneberg, 2017-03-24:
We have received the PVC and the motors.  Still need motor backing plate and the order from RoboShop.com.

dylanvaughn, 2017-03-30:
We are going to try to build the motor backing plate.  I'll open another issue for that.

Closed 2017-04-05.

Thread 30 (2017-03-08):

prototype electronics + motors

dylanvaughn, 2017-03-08:
solder and document build

JamesNewton, 2017-03-09:
I noticed that the [Arduino UNO](https://www.arduino.cc/en/main/arduinoBoardUno#techspecs) has both 5 volt and 3 volt regulators on board, and the 5 volt one is rated for 	7-12V so as long as we just use 12 volt batteries, we should be ok with that. My [BOB breakout board](http://techref.massmind.org/techref/microchip/bob.htm) has terminals which make it easy to hook up to that (no need for the barrel connector used on the Arduino). If we used higher voltages, the regulator option on my BOB can manage up to 48 volts and then the Arduino could produce 3V.

I'm only mentioning the 3 volt supply because it's needed to run an [ESP-8266](http://techref.massmind.org/techref/esp-8266.htm) if we decide to add the [web interface](http://techref.massmind.org/techref/ESP8266/WebSerial.htm).

The BOB also supports a small LCD display, and I think we should be able to get it to work on the UNO while still providing signals for the drivers, but it may be that the LCD won't update when moving. No great loss. It's mostly for monitoring voltage levels and providing a UI to change motor response. I plan to wire that up in the next few days just for testing. I did something like it already for my [Reagent Robot](https://hackaday.io/project/4197-reagent-robot), so I'm sure it will work, I'm less sure it will be useful... let me know what you think.

Based on feedback at the meeting on the cost of H-bridge drivers, I've decided to lower the price on [my h-bridge kit](http://techref.massmind.org/techref/io/motor/DRV8701s.htm). It's now under $10 (and, of course, I'm donating 2 to the project). I STRONGLY doubt that the cheap drivers available from China on ebay can actually manage the power they are advertizing, and I KNOW that mine can, but it is a kit, you must solder it together, and so making it cost competitive is... necessary. The main reason I want to use it is that it directly connects to the BOB with a simple cable, there are no wiring issues, and again, I KNOW it works. I plan to solder up a couple before the next meeting so we won't lose any time with that. If someone else wants to build a set with their own driver, that's great!

That's all for now.

tnahcrem, 2017-03-09:
I think we need to add Steve, Oscar to this thread to do the scheduling for our next meet. (unless we plan to do the scheduling via another channel).

As for my availability; I am out of country from 3/11 - 3/19 for business travel.
I can be available after during evenings our a couple hours on weekend.

dylanvaughn, 2017-03-09:
@tnahcrem I think the best place for general discussion is the Google Group:

https://groups.google.com/forum/#!forum/robomakery-pvc-chair

@SBerneberg is already on the list, but @JamesNewton and Oscar (and yourself) would need to sign up.

tnahcrem, 2017-03-09:
Thanks. I have joined the group.
@JamesNewton  Can you also join the group. I will try to get in touch with Oscar via text and get him in too.

dylanvaughn, 2017-05-03:
We got the basic electronics and motors working in the latest build meeting - closing this

Closed 2017-05-03.

Thread 31 (2017-03-08):

research arduino code for v2 control

dylanvaughn, 2017-03-08:
Are there existing libraries for controlling motors with a joystick?

Document functional requirements for software and technical approach.

In future state arduino may communicate joystick commands to odroid to do high level control.

dylanvaughn, 2017-03-08:
Oscar + Husein

tnahcrem, 2017-03-09:
Hi Dylan,
Can you please grant me access to the project ?
Thanks,
husein

dylanvaughn, 2017-03-09:
@tnahcrem done!

tnahcrem, 2017-03-09:
This is a good/easy tutorial to get started with the joystick on arduino.
https://www.arduino.cc/en/Tutorial/JoyStick

Also attached zip contains  refrence document from a Joystick vendo(parallax)
[27800-2-Axis-Joystick-KickStart.zip](https://github.com/robomakery/pvc-powerchair/files/832232/27800-2-Axis-Joystick-KickStart.zip)

miliapa, 2017-03-10:
https://www.engineersgarage.com/contribution/joystick-controlled-dc-motor

tnahcrem, 2017-03-10:
@miliapa  Thanks for sharing. It looks like I have to register to get access to source code ? If you have access can you share the code with us ?

johanisforever, 2017-03-17:
A few days I spoke to Husein, and we agree that we need to start developing the program base on
the following code. We will use what we can.

https://www.arduino.cc/en/Tutorial/JoyStick

To code and test I built a prototype. I will be passing it to Husein once he comes back from his trip since I also will be going on a trip. We will be using Arduino. I will attach pics of the development platform, don't laugh it is just a development board.
Thing to keep in mind:
-I included a diagram of the current set up.
-I included a list of parts of the current set up and the required parts for the final set up.
- I include some pushbutton and light so we can code it in a way that when completed the PWM can be adjusted easy for different motors.  Different motor may need different PWM frequencies for optimum performance. Also, high RPM with low gear motors will need shorter duty cycles to prevent the motor from spinning too fast.
-currently I chose a  10 Amp h-bridge to power small motors, the final product will require a higher Amp h-bridge and higher wire gage.
- The 12Volt battery for the current set up may be too heavy, so I may have to swap out batteries.
-IMPORTAN!!!!! use the LEDs to first test the both the  PWM and the break signals before making the final connection the H-bridge. Giving both a commands, forward and back, at the same time will result in a short that will destroy the h-bridge.
-To prevent any damage a fuse of 8 amp will protect the entire circuit.
- as far as PWM I would like to start with 25% duty cycle, then see how fast the motor rotate, if they are too slow we can increase the duty cycle until we determine the max allowable speed. once we agree on the max allowable speed for a particular motor, we can divide the duty cycle by 5 increments. I say by 5 because I believe that 5 speeds would be enough for the wheel chair,
Example:If a reasonable fast speed is attained at 50% duty cycle. then 40%, 30%, 20%, 10% duty cycles will control the slower speeds, naturally 0% would be stopped.
Now this idea may, or may not work, but once the code be completed, we can experimentally determine if those are good values.
a different motor will require different max speeds, but we can write the code with options to set the max speed via push buttons. For safety we could put a requirement that to enable the push buttons the user would have to temporary jumper a particular input to a particular output and so entering the "setting mode" once the jumper is removed, accidental pressing of any button would not have any effect.

I did not included the charging circuit yet, but any trickle charger will do.

Note to all, my schematic does not supersede the V1_5 Drawing.pdf submitted a week ago, rather it complements it.
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
[parts.docx](https://github.com/robomakery/pvc-powerchair/files/851821/parts.docx)

johanisforever, 2017-03-17:
this are the images of the "development platform"
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

Closed 2017-05-05.

Thread 32 (2017-03-08):

Find build space

dylanvaughn, 2017-03-08:
Possible Locations:

* OSML https://www.opensourcemakerlabs.com/
(Investigate getting a group membership that we can use for builds.)
* Dylan's garage
* Steve's garage

JamesNewton, 2017-03-09:
dan@opensourcemakerlabs.com

dylanvaughn, 2017-03-09:
@SBerneberg @JamesNewton what tools do we need for the build?

JamesNewton, 2017-03-09:
For the electronics only:
Soldering Iron, solder, workbench, good light.
Basic hand tools (pliers, screwdrivers, bias cutters, strippers, etc...)
Multimeter, scope would be nice for troubleshooting.
PC with USB port and Arduino IDE installed or internet connection to install it.
and one other tool which it absolutely critical and won't be thought of until we can not proceed without it.

I have all that stuff here in my office in Escondido, but it's rather cramped, and could really accommodate only one or two other people.

I should just build it and video? I'd really rather work with someone... Maybe Steve or someone else could stop by.

dylanvaughn, 2017-03-09:
@JamesNewton I would prefer to build it together as well.  My garage might be a good option.  I have basic electronics and other tools and room for probably six people comfortably.  It is in PB however :).

I also have emailed OSML to see what options we may have there.

JamesNewton, 2017-03-09:
I checked and PB is basically an hour away from Escondido on a weeknight, but it's about 40 minutes on a weekend. I'm open to driving to PB on e.g. 3/18 afternoon and I could bring others from NC or we could meet up. e.g. Steve could drive over from Spring Valley and meet me at my place, then we could go on and pick up people in SM or meet people from Vista and points west at a park and ride before heading south down the I-15. Perhaps someone costal could do the same from Vista.

At the same time, I'm liking the idea of just building a basic version here and now, to test and debug where I have all my tools, maybe with Steve or a very small group of those who are really interested, and then meeting up in PB or wherever to install it in the chair or onto the real motors, etc... that I don't have here. We could do that this weekend, e.g. 3/11 or 3/11 in the afternoon, or one evening next week (except Wednesday). We could record and present what we did, and possibly re-build another set at the main meeting if that has value.

dylanvaughn, 2017-03-30:
We had a build meeting at Dylan's garage and it worked fine as a location - I'll plan on hosting at least one build meeting per month (in addition to the planning meeting).

Closed 2017-03-30.

Thread 33 (2017-03-08):

knowledge transfer of BLDC motors

dylanvaughn, 2017-03-08:
From SJ to Aki

bus710, 2017-03-08:
https://github.com/bus710/study_chibios_linux

This is the manual mentioned last night.
The actual session will be held soon.

dylanvaughn, 2017-03-30:
This has been done:

https://groups.google.com/forum/#!topic/robomakery-pvc-chair/MaOPvC08z-g

Closed 2017-03-30.

Thread 34 (2017-03-16):

BOM in editible format?

JamesNewton, 2017-03-16:
Would it be possible to transition the new BOM to something editable like a text document (.CSV, .TSV) or a google sheet so that those of us without Excel can edit it?

https://github.com/robomakery/pvc-powerchair/blob/develop/docs/PVC%20Parts%20List-V2.xls

Github plays nicely with .CSV:
https://help.github.com/articles/rendering-csv-and-tsv-data/

If that is acceptable (e.g. no one objects) I'll just do it.

dylanvaughn, 2017-03-16:
@JamesNewton the CSV support for GitHub is neat - I haven't seen that before.  It would be nice to have the BOM in the source code (as a csv).  I would vote for that or Google Sheets.

JamesNewton, 2017-03-16:
Ok, it's there as the csv. I updated it with links to the parts I'm donating, and tweaked the formatting a bit to fit better on the page. Honestly, it's a bit of a pain to edit as a CSV file, but it is nice to have the BOM in source.

dylanvaughn, 2017-03-16:
I like it!

Closed 2017-03-16.

Thread 35 (2017-03-30):

Print joystick enclosure

dylanvaughn, 2017-03-30:
Current part:

https://github.com/robomakery/pvc-powerchair/blob/develop/hardware/printed_parts/JoystickEnclosure.STL

Needs to be created in OnShape.  We also would like to add a bottom plate which can be screwed into this piece.

dylanvaughn, 2017-05-03:
Update from planning meeting:

* research if we should redesign this piece

dylanvaughn, 2017-06-07:
Since we don't have the old joystick board we can make this lower profile and add a lower piece.  Still planning on 3d printing this piece.

dylanvaughn, 2017-09-06:
for v2 we are going to print the part as is

badiozam, 2017-09-06:
Hey Dylan, do you have the direct link to OnShape? I found https://cad.onshape.com/documents/afa971ef5507b38d69394b06/w/1b6f32bd7bb64483d9a5f636/e/bac4a40611c0be1aa8d12fcc but I don't think that's the right one because it doesn't have the part on there.

McCAndrew88, 2017-09-07:
I can share it with you, what is your email?

badiozam, 2017-09-07:
Hey Andrew, It's my github username at yahoo. Thanks!

-Hamid

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

McCAndrew88, 2017-09-07:
You should have access to it now.

The JoystickEnclosureV2 is the one I modeled after what we have and you
should be able to export an STL out of that.

V3 is the lower profile one, but the bottom tabs don't work well. The
bottom still needs design tweaks.

https://cad.onshape.com/documents/4aca10982c02d999f4bbff8b/w/3f4c62dba35cde9e394a6221/e/2ed27eae5eff1055e6bc6cef

You can edit anything, just makes sure to make a new version.

Let me know if you have any questions!

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

--
Andrew McCarthy
andrewmccarthy88@gmail.com | (408) 646-9550
Mechanical Engineering
UCLA Class of 2013

badiozam, 2017-09-07:
Awesome, thanks!

-Hamid

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

badiozam, 2017-09-08:
I went ahead and pinted the part out and I was able to get it to fit onto a 1/2" PVC I had laying around.
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

However, for some reason the outer ring came out a little warped:
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

I think I can get rid of it if I adjusted the support threshold in my slicer settings but I wanted to ask if you think it's acceptable as is.

dylanvaughn, 2017-09-08:
Looks good to me!

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

Closed 2017-10-11.

Thread 36 (2017-03-30):

CADify Motor/Gearbox plate

dylanvaughn, 2017-03-30:
We need to create an OnShape CAD / STL version of this:

http://www.openwheelchair.org/Products/GearBox-Plate/

Then we should talk about whether we want to stick with aluminum or try acrylic (which we could cut at MakerPlace)

McCAndrew88, 2017-03-31:
I can get on this as soon as I get my hands on the part.

dylanvaughn, 2017-04-05:
plan to use acrylic for v2 and laser cut at makerplace

McCAndrew88, 2017-04-10:
Finished the motor plate and 3D printed a thinner version of it to make sure it would be good tolerances. Seems good, and CAD is up to date. Should I look into getting it made this week?

dylanvaughn, 2017-04-10:
Do you have access to a laser cutter? If so that would be great. I was
planning on renewing my membership to makerplace to get it cut...

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

McCAndrew88, 2017-04-10:
No I do not have access to a laser cutter, so your makerplace will probably
be the best option.

What do you need me to provide you to get it cut on the laser cutter?

On Mon, Apr 10, 2017 at 9:36 AM, Dylan Vaughn <notifications@github.com>
wrote:

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

--
Andrew McCarthy
andrewmccarthy88@gmail.com | (408) 646-9550
Mechanical Engineering
UCLA Class of 2013

dylanvaughn, 2017-04-10:
OK sounds good - I forget the process for generating the appropriate file
but I think I just need an STL to start, which I will get off of OnShape.

On Mon, Apr 10, 2017 at 9:53 AM, McCAndrew88 <notifications@github.com>
wrote:

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

dylanvaughn, 2017-04-10:
Motor plate in OnShape is here:

https://cad.onshape.com/documents/e45c7a3e9ffce924c9f8be0e/v/b85c2a483f26aa34e6aeb54a/e/d49b3f0c8c964535a9f3ce61

McCAndrew88, 2017-04-10:
Yep, that is it. Right now V1 is set to the 3.3mm thickness of the aluminum
so to make it more accurate, let me know what thickness of acrylic we want
to use.

On Mon, Apr 10, 2017 at 10:38 AM, Dylan Vaughn <notifications@github.com>
wrote:

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

--
Andrew McCarthy
andrewmccarthy88@gmail.com | (408) 646-9550
Mechanical Engineering
UCLA Class of 2013

dylanvaughn, 2017-05-03:
Make new issue to track sourcing this piece (see #40)

Closed 2017-05-03.

Thread 37 (2017-04-05):

Research and purchase motor driver

dylanvaughn, 2017-04-05:
example:

http://www.ebay.com/itm/60A-High-Power-MOS-Dual-Channel-H-bridge-DC-Motor-Driver-Module-/181947954406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

Find similar products on roboshop and / or sparkfun

Send selection to mailing list, then purchase

dylanvaughn, 2017-04-07:
Another option:

https://smile.amazon.com/Sabertooth-Dual-12A-Motor-Driver/dp/B00CT5CHIC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

dylanvaughn, 2017-04-07:
Or this:

https://www.amazon.com/Sabertooth-Dual-25A-Motor-Driver/dp/B008OMQUXC

SBerneberg, 2017-04-07:
I am re-thinking this whole motor driver thing.  The motor drivers with more drive capability are very expensive.  We could purchase a couple of the drivers with lesser current drive than one with more current drive.  I would say get the one that we currently have, and get it working and take a chance that we will not have rotor lock that will last very long.  Let's spend the resources on a better solution like the brushless approach.  I would however put some heatsinks on the transistors so we have a better chance of surviving a rotor lock.

SBerneberg, 2017-04-07:
Sorry, didn't mean to close this...still learning.

dylanvaughn, 2017-04-09:
@SBerneberg I bought this one:

https://smile.amazon.com/Sabertooth-Dual-12A-Motor-Driver/dp/B00CT5CHIC

before I got your recent messages :smile:

Let's use the one I bought for v2 - things are going to change for v3 b/c of the BLDC motors anyway.

Closed 2017-04-09.

Thread 38 (2017-04-05):

Create new electronics / battery enclosure

dylanvaughn, 2017-04-05:
after all parts are determined create a design for the enclosure.

possibly laser cut as well

dylanvaughn, 2017-05-03:
Notes from planning meeting:

* Possibly use 1/4" acrylic

dylanvaughn, 2017-06-07:
For v2 let's just get a box

dylanvaughn, 2017-07-07:
Look at Fry's

Closed 2017-09-06.

Thread 40 (2017-05-03):

Cut motor plates

dylanvaughn, 2017-05-03:
Research either getting the plates cut at makerplace or using an online service (a la Shapeways) that will cut the parts for us.

McCAndrew88, 2017-05-05:
Getting these cut through customlasercutting.com which is actually Pololu Laser Cutting. There is a minimum order on these so I am getting 3 motor mounts. They come next Wednesday and hopefully match well with the gear boxes. I'll close this issue after I know they will work.

McCAndrew88, 2017-05-12:
Motor mounts are cut and fit nice!
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

dylanvaughn, 2017-05-12:
@McCAndrew88 Looks good!  What was the cost?

McCAndrew88, 2017-05-12:
$33.45 for 3 after shipping and everything. They did a really good job and it was quick, they just had a minimum so I had to order 3. Still shopping around for other places, will see what I come up with once I finish the bottom plate and box.

dylanvaughn, 2017-06-07:
completed

Closed 2017-06-07.

Thread 41 (2017-05-03):

Battery level indicator - research

dylanvaughn, 2017-05-03:
Research battery level indicator attached to arduino.

When battery is low, turn on LED.

dylanvaughn, 2017-05-03:
Assign to Rob once Dylan gets his github username.

rbeetem, 2017-05-07:
github user name rbeetem

rbeetem, 2017-05-23:
Basically a voltage divider. Two known value resistors fed to Arduino analog input. Arduino input is 0-5v, 10 bit resolution.

Implementation Example:
http://henrysbench.capnfatz.com/henrys-bench/arduino-voltage-measurements/arduino-25v-voltage-sensor-module-user-manual/

Add logic for LEDs in Arduino code.

TODO: number of LEDs desired? (1 red) or (1 red and 1 green) or (1 red, 1 yellow, 1 green) or anything else.

dylanvaughn, 2017-06-07:
Need to identify parts and add to the BOM and drawing

dylanvaughn, 2017-06-07:
Let's go with a OLED display:

https://www.google.com/search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

Closed 2017-07-07.

Thread 42 (2017-05-03):

Create CAD model for bottom frame plate

dylanvaughn, 2017-05-03:
For v1 @SBerneberg made this out of wood - for v2 we are planning on using acrylic.

dylanvaughn, 2017-06-07:
this is complete for v2 build

Closed 2017-06-07.

Thread 43 (2017-05-03):

Complete frame build

dylanvaughn, 2017-05-03:
* Install wheels
* Install motors plates
* Install bottom frame plate
* Install gearboxes
* Install casters
* Wiring

Closed 2017-09-06.

Thread 44 (2017-05-03):

Clamp for reclining pipe

dylanvaughn, 2017-05-03:
Currently the pipe that controls the reclining of the seat is loose.  Research how to tighten this once the desired decline is reached.

Ideas:

* Hose clamps
* Rubber o-ring

dylanvaughn, 2017-07-07:
@SBerneberg tried the two above options and determined they will not work - need other ideas

maybe:

* Drill holes in pipe and use rod to stop movement
* ???

@McCAndrew88 ideas?

dylanvaughn, 2017-07-07:
Maybe this:

https://www.amazon.com/gp/product/B01MF4M54W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

McCAndrew88, 2017-07-07:
Those hose clamps seem like they would work. What was the problem with them?

If those don't work, I like the idea of using a rod to stop the movement like machines at the gym. I can prototype something for that idea.

dylanvaughn, 2017-07-09:
@McCAndrew88 no issue with the hose clamps - I'm going to buy those to try.

Closed 2017-10-11.

Thread 45 (2017-05-03):

Integrate joystick library with new electronics

dylanvaughn, 2017-05-03:
Based on research done in #31 get motors working with arduino and motor driver.

dylanvaughn, 2017-05-03:
Rob to take

rbeetem, 2017-05-07:
user name rbeetem

rbeetem, 2017-05-23:
Prototype build. Awaiting actual hardware for testing.

rbeetem, 2017-08-04:
Added Arduino code to software folder.

pvc-powerchair/software/Arduino/OpenSourceWheelChair.ino

Closed 2018-02-22.

Thread 46 (2017-05-03):

Integrate electronics into frame

dylanvaughn, 2017-05-03:
Based on system diagram build a prototype for chair that demonstrates all parts of the electronics build working together.

dylanvaughn, 2017-09-06:
Also need to incorporate fan for motor controller

Closed 2017-10-11.

Thread 48 (2017-07-07):

Cut bottom plate

dylanvaughn, 2017-07-07:
Cut the bottom plate (which will attach to the casters) as shown in the OnShape model

McCAndrew88, 2017-07-07:
Before we do this, can we get the updated width of the current prototype?

Mainly, the length of the PVC pipes running across the seat and back. I can create a new version of the assembly that is to the current specs so we can cut the correct lengths of the back.

dylanvaughn, 2017-07-24:
@McCAndrew88 the numbers are in the 'PVC_2' tab of this spreadsheet:

https://github.com/robomakery/pvc-powerchair/blob/develop/docs/PVC%20Parts%20List-V2.xls

Please let me know if you want me to verify some of the measurements by hand.

dylanvaughn, 2017-08-02:
@McCAndrew88 we took some measurements while looking at the CAD model and think the piece of wood should be 14.25" x 7", with wheel cutouts down to 11.5" x 4.75".

McCAndrew88, 2017-08-02:
@dylanvaughn I am going to update the cad model with the new specs that you sent. The current is the original model and much smaller. I will get the dimensions from that and look for a place to cut the bottom unless someone has a way to cut them?

Also, the way it is set up, if we want to move the box to the middle, we will have to make some kind of spacers for the casters.

dylanvaughn, 2017-08-29:
@McCAndrew88 I plan to cut the wood at my house this Thursday with @SBerneberg - could you let me know if I am good to get the dimensions from the CAD model or should I look at the current prototype under construction?

McCAndrew88, 2017-08-29:
The model is up to date with all the dimensions in the spreadsheet you sent so it should be good!

Closed 2017-09-06.

Thread 50 (2017-09-06):

Research connectors for motor wiring, joystick, OLED

dylanvaughn, 2017-09-06:
Initial thought is

* Joystick: RJ45
* OLED: RJ45
* Motors: 2-pin half-screw-in connectors

Closed 2017-10-11.

Thread 53 (2017-10-11):

Troubleshoot electronic connections

dylanvaughn, 2017-10-11:
Currently experiencing signal noise / garbled text on OLED when Joystick inputs are connected to Arduino.

dylanvaughn, 2017-11-08:
fixed!  rewired everything to have individual wires instead of ethernet cable

Closed 2017-11-08.

Thread 55 (2017-10-11):

Create prototype board

dylanvaughn, 2017-10-11:
Needs:

* Ethernet jack that can go directly on prototype board
* Change voltage sensor so it can be mounted on board
* Screw attachment that fits on prototype board for motor driver

dylanvaughn, 2017-11-08:
used new prototype boards with terminal connectors instead

Closed 2017-11-08.

Thread 57 (2017-10-11):

Research ideas for frame v3

dylanvaughn, 2017-10-11:
Ideas:

* Replace some of the lower frame PVC with metal tubing
* Hang electronics box from seat?  How should this be mounted?

dylanvaughn, 2017-10-11:
* Larger wheels
* New motors (BLDC) & ESCs

dylanvaughn, 2018-01-10:
Current plan is to use electrical metal conduit and MakerPipe instead of PVC:

https://makerpipe.com

Closed 2018-02-22.

Thread 58 (2017-10-11):

Swap out ROS + Odroid for Arduino

dylanvaughn, 2017-10-11:

Thread 63 (2018-01-10):

Research encoders needed with hub motor and oDrive

dylanvaughn, 2018-01-10:
https://discourse.odriverobotics.com/t/which-encoders-to-choose/63

SBerneberg, 2018-01-10:
The comments in this section are correct.&nbsp; I understand the off-axis encoding but you have to make sure that you compensate for the off-axis.

&nbsp;

Spatial Applications
sberneberg@spatialapplications.com
(760) 749-9660

This message is intended only for the use of the individual or entity to which it is addressed and may contain information that is privileged confidential and exempt from disclosure. If the reader of this message is not the intended recipient or an employee or agent responsible for the delivering the message to the intended recipient, you are hereby notified that any dissemination, distribution or copying of this communication is strictly prohibited. If you have received this communication in error, please notify us immediately by telephone and return the original message to us by mail. Thank You.

**********************************************************************

This message and any attachments may contain legally privileged and/or
sensitive information. Any unapproved disclosure, use or dissemination
of this e-mail message or its contents, either in whole or in part, is
not permitted. If you are not the intended recipient of this e-mail
message, kindly notify the sender and then securely dispose of it.

**********************************************************************

On Wed, 10 Jan 2018 02:59:38 +0000 (UTC), Dylan Vaughn  wrote:
&nbsp;
https://discourse.odriverobotics.com/t/which-encoders-to-choose/63

—
You are receiving this because you are subscribed to this thread.
Reply to this email directly, view it on GitHub, or mute the thread.

&nbsp;

dylanvaughn, 2018-02-07:
potential product with good motors:

https://www.amazon.com/Segway-miniLITE-Balancing-Transporter-Integrated/dp/B074CYX5PT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

dylanvaughn, 2018-06-24:
We are going to use these encoders for v4:

https://odriverobotics.com/shop/cui-amt-102

Closed 2018-06-24.

Thread 66 (2018-02-22):

Buy makerpipe connectors and EMC

dylanvaughn, 2018-02-22:
Also need the heat shrink for color

dylanvaughn, 2018-02-22:
@AkiKono could you please put in the makerpipe connector information we need to build the original frame?

AkiKono, 2018-02-22:
Here is the number of connectors we need to build one wheelchair. (v2)

PVC WheelChair        MakerPipe
Connector A         =     90 degree connector       = x10
Connector B         =     ------
Connector C         =     90 degree                       = x6
Connector D         =     90 degree connector      = x6
Connector E         =     T-Connector                   = x2
Connector F         =     T-Connector                   = x7

In total, 90 degree connector  x22 and T-connector x9.

The maker pipe connectors' length is different from that of PVC pipe connectors, so the length of the  electrical conduit pipes might be different from the length of the PVC pipes.

dylanvaughn, 2019-06-05:
this was done

Closed 2019-06-05.

Thread 68 (2018-02-22):

Create CAD model for electronics box

dylanvaughn, 2018-02-22:
Assign to Collins once he is added to the project.

dylanvaughn, 2019-06-05:
@collm2 the current thought on this is to buy a weatherproof box and then design some 3d printed mounts for the inside of the box to hold the various electronics.

Thread 69 (2018-02-22):

Research Rocker Bogie Suspension Design

dylanvaughn, 2018-02-22:

AkiKono, 2018-05-24:
Hi all,

Yuriy, thank you for your continued contribution and cooperation to the powered wheelchair project :)
We shared your PPT slides in today's bi-weekly meeting, and we appreciate a lot of your great inputs :)
I would like to attach your PPT slides here.
[Robo-Wheelchair_Info_rev1.pptx](https://github.com/robomakery/pvc-powerchair/files/2033949/Robo-Wheelchair_Info_rev1.pptx)

Dylan, from what I comprehended from the meeting today, I and Yuriy should now think more about the details of the frame design of rocker boogie mechanism (like which bearing to buy, how to mount wheels, etc...) and solidify the CAD model.
And do you think we can use bent electrical conduit pipes in our rocker bogie frame design?

yuriyFsd, 2018-05-31:
Hi Aki, 
Hope you're doing well/ 
thank you for the good feedback. Maybe there are some technical comments or questions from the team, maybe regarding additional lifting force?
I'm sorry that I cannot devote more time these days. The situation is like that: we've got an urgent project and we are in not very good financial conditions to take any risks. So I need to be fully involved in the project and don't have time for something else.. I believe that in 1.5 - 2 weeks I will have more time to get back to the wheelchair project. 
Didn't you have a chance to contact to "pipemakers" with the question about a tense load capacity of their connections?
Kind regards, Yuriy
   On Thursday, May 24, 2018, 8:39:45 AM GMT+3, Aki (Saitoh) Kono <notifications@github.com> wrote:

Hi all,

Yuriy, thank you for your continued contribution and cooperation to the powered wheelchair project :)
We shared your PPT slides in today's bi-weekly meeting, and we appreciate a lot of your great inputs :)
I would like to attach your PPT slides here.
Robo-Wheelchair_Info_rev1.pptx

Dylan, from what I comprehended from the meeting today, I and Yuriy should now think more about the details of the frame design of rocker boogie mechanism (like which bearing to buy, how to mount wheels, etc...) and solidify the CAD model.
And do you think we can use bent electrical conduit pipes in our rocker bogie frame design?

—
You are receiving this because you were assigned.
Reply to this email directly, view it on GitHub, or mute the thread.

dylanvaughn, 2019-06-05:
Let's put this on hold for now - thanks!

Closed 2019-06-05.

Thread 70 (2018-02-22):

Update BOM for v4

dylanvaughn, 2018-02-22:
Based on what the capstone team is working on and what other features we want to do, update the existing bill of materials so it is up to date.

collm2, 2018-02-28:
Hi Dylan, Let me know if you have the specific  and most updated BOM with the link to the parts on amazon or elsewhere. I can't seem to find/locate such a file. Again I could be checking in the wrong place...

dylanvaughn, 2018-06-25:
BOM started here for v4:

https://github.com/robomakery/pvc-powerchair/blob/develop/v4/BOM.md

dylanvaughn, 2019-06-05:
moving to emt-powerchair project

Closed 2019-06-05.

Thread 71 (2018-03-01):

Software between joystick nano and main arduino

badiozam, 2018-03-01:
Develop software for connecting an arduino nano to the joystick and having the nano communicate to an arduino uno for driving the motors.

badiozam, 2018-03-06:
Hey guys, so I did some work on this and there are some considerations we have to make.

Consider first that we have our OLED screen currently being driven by the Arduino UNO via I2C. Now we can have the Nano connect to the joystick, translate joystick values into commands and then either:

1) have the UNO poll it on I2C before sending it off to the motor controller.

OR

2) send the commands to the UNO via Serial comms at 115200 bps (i.e. UNO listening).

With method 1 there are fewer cables (GND, Vin, SDA, SCL) but less bandwidth. I2C operates on the Arduino at 100kHz (it can be bumped up to 400kHz with some tweaking but only between like-speed devices which I don't think our OLED can do but I'm not sure). Now given that we transfer 1 bit per clock cycle we end up at 100kbps which is 15% slower than method 2. And we also have to consider that the Nano would have to share the bandwidth with the OLED on the I2C bus. It's certainly doable especially if we're not doing fancy graphics on the OLED and given that commands are typically only a few bytes long, but we should be cognizant of the limitation.

With method 2 there are a couple more cables (GND, Vin, SDA, SCL, RX, TX) but there's more bandwidth, and more importantly, dedicated bandwidth (i.e. no race conditions on the wire). However, we get hit with a double whamy in the maintainability aspect:

    a) we'd have to disconnect the Nano from the UNO any time we want to upload sketches to either one since they both need their respective serial ports for upload/download and

    b) we couldn't use the serial ports to output debug messages so we're basically blind unless we can use the OLED for debugging.

There is a another option and that is to use a beefier Arduino. I'd recommend the Arduino MEGA2560. AliExpress sells them for $9 if you're willing to wait 60 days or you can buy them on Amazon for $14 in 2 days. The Mega has a larger footprint than the UNO (I'll bring them all tomorrow so we can see), but it has 4 Serial ports and more RAM and way more pins. I think it should be able to handle an OLED, a joystick, a motor controller, and comms to a higher level board (i.e. autonomy) all in one sketch and on one board.

JamesNewton, 2018-03-06:
Minor suggestions: If there are spare pins on the UNO, you can "bit bang" either I2C or UART. So you can have a second I2C bus (not shared with the display) or you can have an RX/TX that is seperate from the main one (no interference with bootloading or debug). Look for "Software Serial" or "Software I2C" (I think... Software Serial for sure). Here it is, I looked it up for you:
https://www.arduino.cc/en/Reference/SoftwareSerial

The only downside is that they take up a bit more processor time (shouldn't be an issue) and they can't operate as fast. 57600 baud max for serial. But for a mechanical system on human time, like the joystick, 100K or even 57600 is total overkill. That is 5760 updates per second.

Another point: You don't need TX back from the Uno to the Nano. Data is only flowing one way, so the Uno only needs a RX pin. On the Uno, you can't use software serial RX on pin 13, but any other available pin will work.

badiozam, 2018-03-06:
All valid points James.

I have used SoftwareSerial before and it sucked up too much of the processor's time for my purposes. Although, as you pointed out we could likely slow down the baud rate even lower than 57.6k max and not suffer any noticeable performance at this stage (in the future we may want to add more functionality to the UNO which might begin to encroach).

Also, a good suggestion on doing away with the TX back from Uno. No need for that wire that I can see.

Also just for a little more background: I think the reason we wanted to add a Nano next to the joystick rather than directly connecting the joystick to the UNO was to avoid having a lot of analog wires going all the way down to the base which may become noisy/lossy. This way, we interpret at the Nano level with short wires and then send commands digitally where we can do CRC checks (which would allow us to drop noisy/lossy packets).

I'm still leaning I2C with Uno or Mega with hardware UART, only because the Mega is cheap and we have the space for its footprint and we can get more bang for the buck for future proofing.

JamesNewton, 2018-03-06:
Very (very) wise to get away from long analog runs in this application. Honestly, low speed serial is so reliable that CRC is probably not needed. The better choice is to add a low value resistor in series and a low value cap in parallel to take the edge off the digital transitions, and run a couple of ground wires along side. Ribbon cable (ground on every other pin) or shielded cable is wonderful. Very long runs, digital data with smooth state transitions, no problems for miles. Literally. Higher voltages needed if the wire is thin.

Yeah, even 9600 is 960 updates a second, so at that speed, the impact on the processor is minimal.

Having said all that, totally agree the Mega is cheap and having lots of IO is good. I don't agree that buying knockoffs is ethical, but I'm weird that way. I like seeing Massimo get a penny out of each sale.  Just my opinion, no judgement. no, I'm totally judging you. no, just kidding. ,o)

badiozam, 2018-03-29:
Just following up on our conference call discussion. Here's the USB host shield for the UNO that we can use for connecting game controllers instead of a custom joystick.

https://store.arduino.cc/usa/arduino-usb-host-shield

badiozam, 2018-03-29:
Here's the Amazon link:

https://www.amazon.com/Arduino-org-A000004-Arduino-Host-Shield/dp/B00LUJYN5S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

Closed 2018-06-27.

Thread 72 (2018-04-05):

Update CAD model for frame

dylanvaughn, 2018-04-05:
For v4 we are upgrading to Makerpipe and Eletrical Metal Conduit (EMC).

Also the openwheelchair site itself has released an updated design for the frame:

For this task, update the OnShape model to use the makerpipe connectors, EMC, and the updated frame design.

dylanvaughn, 2018-04-05:
FYI here is the existing OnShape model:

https://cad.onshape.com/documents/d91a95f30dd3844dcfc2804c/w/6f43255d0f5dad638639cf32/e/45c92d8b4a03edc246f1764e

dylanvaughn, 2018-06-25:
Here is the v4 OnShape link:

https://cad.onshape.com/documents/9732789dff1ad6d245e6f6cd/w/41a982015f5ddfd27778e331/e/463536132cf1bdc68d806583

dylanvaughn, 2019-06-05:
this was done - will move next issue to emt-powerchair project

Closed 2019-06-05.

Thread 73 (2018-05-10):

Research Bluetooth control

badiozam, 2018-05-10:
We want to be able to control the wheelchair using a smartphone. Being able to connect via Bluetooth (preferrably class 2 or class 1 for range) would be ideal.

dylanvaughn, 2019-06-05:
This will be covered with the Raspberry Pi 3 Model B+

Closed 2019-06-05.

Thread 76 (2019-06-05):

Create CAD design for 0.1.0 Prototype

dylanvaughn, 2019-06-05:
Updates to existing PVC Chair design:

* Use a solid piece of plywood for the bottom of the chair
* Allow PVC frame to be "snapped" onto plywood but later removed for ease of transport
* Use Swerve Steering Mechanism https://www.thingiverse.com/thing:2680517 for each of the four wheels

Please use FreeCAD for this design.

dylanvaughn, 2019-06-05:
@collm2 please put the FreeCAD files into the `hardware/cad` folder.

collm2, 2019-06-05:
Well noted Dylan. Thank you.

On Wed, Jun 5, 2019 at 4:55 AM Dylan Vaughn <notifications@github.com>
wrote:

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

--
~The purity of human hearts is tested by giving them a little
fame.~Proverbs: 27:21
