robomakery/pvc-powerchair/(list of files, drawings)

Other design files:
archive/v2/docs/fritzing_diagram.fzz
v2/docs/fritzing_diagram.fzz
