robomakery/pvc-powerchair/(commit log)

2016-06-23 last commit before merging.
    [model.sdf]
2016-06-27 change tabs to space2
    [model.sdf]
2016-08-14 edited electronics_diagram
    added STM32f0 in between odroid and openESC
2016-08-21 initial rviz integration
    [materials.xacro, pvcchair.xacro]
2016-10-27 Added urdf model for the frame of the wheelchair * Added dae design files for the basic components. * Added urdf models for the basic components. * Added urdf model for the frame of the wheelchair.
    [arms.urdf.xacro, back.urdf.xacro, base.urdf.xacro, ca.urdf.xacro, cb.urdf.xacro, cc.urdf.xacro, cd.urdf.xacro, ce.urdf.xacro]
2016-10-28 Updated urdf models * Fixed mesh names in urdfs to comply with latest xacro requirements. * Refactored urdf parameters and placed them in parameters.urdf.xacro
    [ca.urdf.xacro, cb.urdf.xacro, cc.urdf.xacro, cd.urdf.xacro, ce.urdf.xacro, cf.urdf.xacro, connectors.urdf.xacro, p1.urdf.xacro]
2016-10-29 Added urdf models for gearbox plates, wheels and casters
    [base.urdf.xacro, ca.urdf.xacro, caster.urdf.xacro, gearbox_plate.urdf.xacro, p1.urdf.xacro, parameters.urdf.xacro, parts.urdf.xacro, wheel.urdf.xacro]
2016-10-29 Fixed caster relative positions
    [base.urdf.xacro]
2016-11-14 Cleaned pvcchair tf tree * Redefined piping and connectors to allow use within a single link. * Restructured main parts so that each defines a single link. * Restructured xacro includes to be compati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
    [arms.urdf.xacro, back.urdf.xacro, base.urdf.xacro, ca.urdf.xacro, caster.urdf.xacro, cb.urdf.xacro, cc.urdf.xacro, cd.urdf.xacro]
2017-03-16 Initial commit
    BOM in CSV format for local editing / update
    [PVC Parts List-V2.csv]
2017-03-16 Add donated parts from MassMind.org
    [PVC Parts List-V2.csv]
2017-03-16 Reduce column widths
    [PVC Parts List-V2.csv]
2017-03-16 Reduce column width again.
    [PVC Parts List-V2.csv]
2017-03-30 adding STL for Joystick Enclosure
    [JoystickEnclosure.STL]
2017-05-05 updating documentation
    [PVC Parts List-V2.ods, PVC Parts List-V2.xls]
2017-05-05 fixing DIP switch settings
2017-10-18 wiring updates
2017-10-28 playing with fritzing
    [fritzing_diagram.fzz]
2017-10-28 adding catch testing framework
2017-10-28 adding example with MotorControl file
2017-10-28 moving motor command code to library
2017-10-28 moving motor control to a class
2017-10-30 first version of motor control
2017-11-08 inverting left and right in motor control
    [MotorControl.cpp]
2017-11-16 not doing 4 wheel drive for v3
2018-05-25 moving documentation into v2 directory
    [PVC Parts List-V2.csv, PVC Parts List-V2.ods, PVC Parts List-V2.xls, fritzing_diagram.fzz]
2018-06-23 removing spaces from names
    [PVC-Parts-List-V2.csv, PVC-Parts-List-V2.ods, PVC-Parts-List-V2.xls]
2018-06-23 moving stuff around
    [PVC-Parts-List-V2.csv, PVC-Parts-List-V2.ods, PVC-Parts-List-V2.xls, fritzing_diagram.fzz, model.sdf]
2018-06-23 moving things into v2 folder
    [JoystickEnclosure.STL, arms.urdf.xacro, back.urdf.xacro, base.urdf.xacro, ca.urdf.xacro, caster.urdf.xacro, cb.urdf.xacro, cc.urdf.xacro]
2018-06-23 moving version folders to top level
    [JoystickEnclosure.STL, PVC-Parts-List-V2.csv, PVC-Parts-List-V2.ods, PVC-Parts-List-V2.xls, arms.urdf.xacro, back.urdf.xacro, base.urdf.xacro, ca.urdf.xacro]
2018-06-25 adding v4 BOM
2018-06-26 Create Battery Indicator(Arduino)
2018-06-26 Rename Battery Indicator(Arduino) to Battery_Indicator.ino
2018-06-26 adding pic of new frame
2018-06-27 updating maker pipe BOM
2018-07-06 BOM Makerpipe updates
2018-07-07 updating BOM
2018-07-07 updating totals for frame
2018-08-02 adding battery to BOM
2018-09-22 moving arduino code around
2018-09-22 lowercase directories
    [version3arduinopins.xlsx]
2018-09-23 Initial check-in of integrated motor controller and I2C OLED display.
2018-09-23 Basic formatting and converting battery voltage to percentage
2018-09-23 Downscaled to 256 for motor speed.
2018-09-23 Further tweaked power settings.
2018-09-23 starting BOM
2018-12-09 Latest BOM
    V 7.1 BOM
    [BOM-20181206_002.xls]
2019-01-22 adding design files for v4
    [PVC_CHAIR_V4_BOM_20181205_005.xls]
2019-01-22 updating link to BOM
2019-06-05 moving things around
    [JoystickEnclosure.STL, PVC-Parts-List-V2.csv, PVC-Parts-List-V2.ods, PVC-Parts-List-V2.xls, PVC_CHAIR_V4_BOM_20181205_005.xls, arms.urdf.xacro, back.urdf.xacro, base.urdf.xacro]
2019-06-05 creating cad directory and adding tools
2021-01-30 Add description and bringup packages
    Set up basic system that launches the model in simulation
    [arms.urdf.xacro, back.urdf.xacro, base.urdf.xacro, ca.urdf.xacro, caster.urdf.xacro, cb.urdf.xacro, cc.urdf.xacro, cd.urdf.xacro]
2021-01-31 Rename bringup package to bringup_sim
    Rename the package to remove the gazebo dependency from the (future) bringup package that's to be installed on the robot
    [spawn_robot.xml]
2021-01-31 Refactor and clean up urdf description
    [arms.urdf.xacro, arms.xacro, back.urdf.xacro, back.xacro, base.urdf.xacro, base.xacro, ca.urdf.xacro, caster.xacro]
2021-01-31 Prepare pvcchair for gazebo
    * Extend urdf description with the gazebo configuration
    * Configure and load controllers in the bringup
    [caster.xacro, controllers.yaml, spawn_robot.xml]
2021-01-31 Rename ros directory to src
    [arms.xacro, back.xacro, base.xacro, caster.xacro, connectors.xacro, controllers.yaml, drive.xacro, gearbox_plate.xacro]
2021-02-01 moving old BOM
    [BOM-20181206_002.xls]
2021-02-14 Replace collada meshes for pipes with cylinder primitives
    Replace meshes with primitives so the model can be freely reconfigured and scaled
    [pipes.xacro]
2021-02-14 Remove gearbox plate
    [base.xacro, drive.xacro, gearbox_plate.xacro, parameters.xacro]
2021-02-14 Fix wheel positioning
    Fix parameterized wheel positions to properly respond to changes in the base level and wheel radius
    [drive.xacro]
2021-02-14 Parameterize wheel offsets
    * Add paremeters that offset the horizontal positioning of the front and rear wheels
    * Add parameter that scales the entire model
    [drive.xacro, parameters.xacro]
2021-02-14 Add swerve wheels
    [base.xacro, drive.xacro, parameters.xacro, swerve_wheel.xacro]
2021-02-15 Update gazebo extensions for swerve drive base in urdf
    [swerve_wheel.xacro]
2021-02-15 Add control launch to sim bringup
    [controllers.yaml]
